markmatamoros-alt/Dancing-Monkeys/README.md

As heavy modifications were required prior to game launch, the Arduino script needs additional refactoring.
