markmatamoros-alt/Dancing-Monkeys/Documentation/Puppet Game Circuit.png

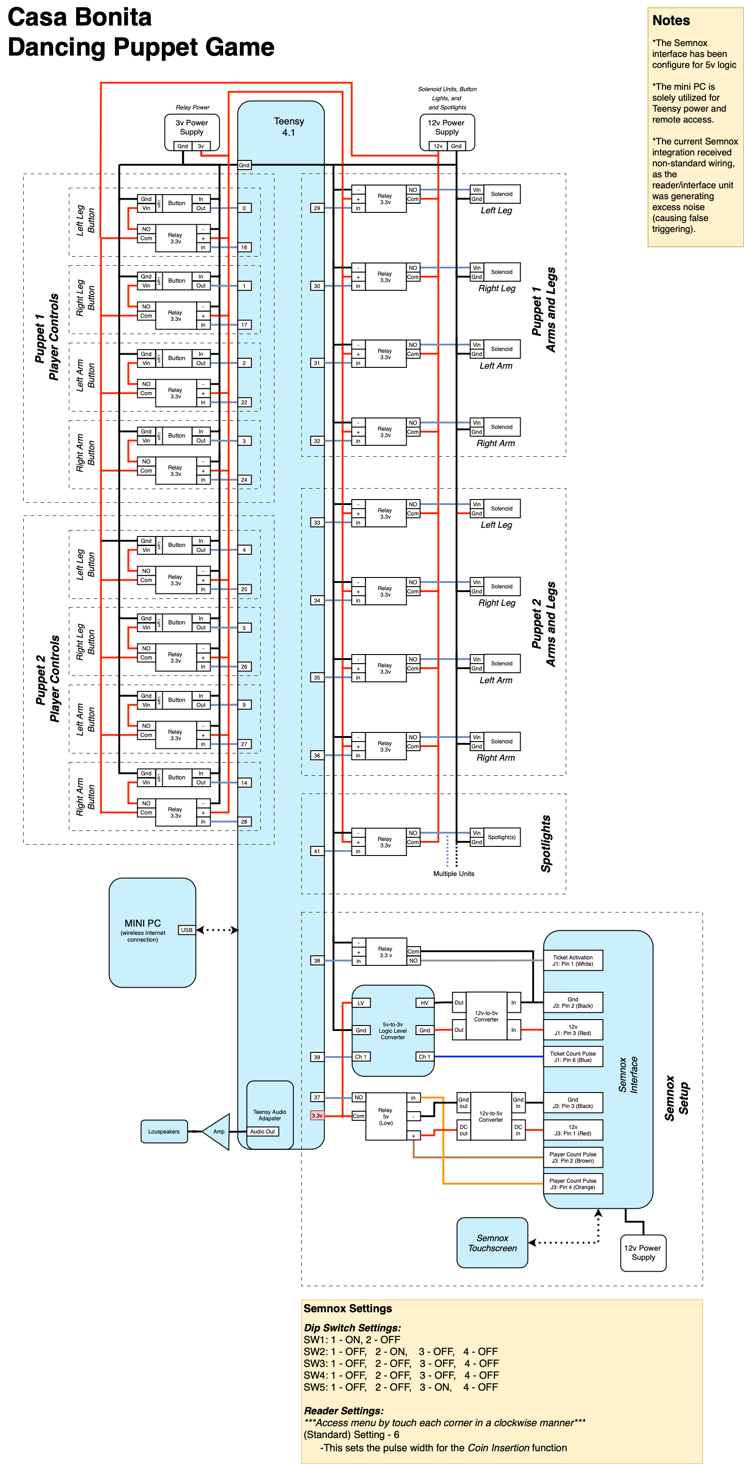
Documentation/Puppet Game Circuit.png
