markmatamoros-alt/Dancing-Monkeys/Documentation/Puppet Game Parts List.pdf

ITEM | LINK | COUNT | NOTES
Teensy 4.1 | Link (https://www.pjrc.com/store/teensy41.html) | 1 | Handles all operation except audio
Teensy Audio Shield | Link (https://www.pjrc.com/store/teensy3_audio.html) | 1 | Produces Audio (headphone jack)
Teensy 4.1 Breakout | Link (https://www.amazon.com/dp/B08R7RJY65?psc=1&ref=ppx_yo2ov_dt_b_product_details) | 1
5v Relay | Link (https://www.amazon.com/HiLetgo-Channel-optocoupler-Support-Trigger/dp/B00LW15A4W) | 1 | For Semnox Integration
3v Relays | Link (https://www.amazon.com/dp/B09W9M83DL?psc=1&ref=ppx_yo2ov_dt_b_product_details) | 19
Power Supply | Link (https://www.amazon.com/dp/B01N2K48HR?psc=1&ref=ppx_yo2ov_dt_b_product_details) | 1 | For 3v Relays
SD Card | Link (https://www.amazon.com/dp/B08J4HJ98L?ref=ppx_yo2ov_dt_b_product_details&th=1) | 1
USB cable | Link (https://www.amazon.com/dp/B08CBDZM6L?psc=1&ref=ppx_yo2ov_dt_b_product_details) | 1 | For Teensy-PC connection
Stacking Headers | Link (https://www.amazon.com/dp/B0B3XBYL3J?ref=ppx_yo2ov_dt_b_product_details&th=1) | 1 Pack | Utilize with all boards: Teensy 4.0, Teensy 4.1, Teensy Audio Shield
Mini PC | Link (https://www.amazon.com/gp/product/B0BKL1SC87/ref=ppx_yo_dt_b_search_asin_title?ie=UTF8&psc=1) | 1 | Feel free to purchase any PC that can handle the Arduino IDE
12v to 5v Step-Down Converter | Link (https://www.amazon.com/Converter-Voltage-Waterproof-Regulator-Step-Down/dp/B07Y2V1F8V) | 2 | Converts Semnox 12v feed to 5v
5v to 3v Logic Converter | Link (https://www.sparkfun.com/products/12009) | 1 | Handles the Teensy 3.3v logic conversion to the Semnox 5v logic (with dip switch settings)
